InjectLink/idc_ng_hardware/output/bom/idcng.csv

Reference | Qty | Value | DNP | Footprint | Datasheet | Manufacturer_Name | Manufacturer_Part_Number | Mouser Price/Stock | Pricep1 | Pricep10 | Pricep100
C1,C3,C4,C9,C14,C15,C16,C21,C22,C23,C27,C30,C31,C33,C34,C35,C37,C38,C39,C40,C41 | 21 | 100n/16V |  | Capacitor_SMD:C_0201_0603Metric | https://www.yuden.co.jp/productdata/catalog/mlcc02_e.pdf |  |  | https://www.mouser.fr/ProductDetail/TAIYO-YUDEN/EMK063BJ104KP-F | 0,086 | 0,042 | 0,03
C2 | 1 | 47u/10V |  | Capacitor_SMD:C_1210_3225Metric | https://www.mouser.com/catalog/specsheets/TAIYO%20YUDEN_03-05-2025_Tayio_Yuden_1102023_MS_mlcc_all_e-3081579-1-65.pdf |  |  | https://www.mouser.fr/ProductDetail/TAIYO-YUDEN/MSASE32MSB5476MPNA01 | 0,774 | 0,517 | 0,372
C5,C8,C20,C32,C36,C44 | 6 | 10u/16V |  | Capacitor_SMD:C_0805_2012Metric | https://www.samsungsem.com/resources/file/global/support/product_catalog/MLCC.pdf |  |  | https://www.mouser.fr/ProductDetail/Samsung-Electro-Mechanics/CL21A106KOQNNNF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 | 0,086 | 0,03 | 0,026
C6,C7,C17,C25,C26 | 5 | 1u/16V |  | Capacitor_SMD:C_0603_1608Metric | https://www.mouser.fr/datasheet/3/508/1/upy-gphc_x5r_4v-to-50v.pdf |  |  | https://www.mouser.fr/ProductDetail/YAGEO/CC0603KRX5R6BB105 | 0,086 | 0,032 | 0,028
C10 | 1 | 1nF/300VAC |  | VY2102M29Y5US6TV7 | https://www.vishay.com/docs/28535/vy2series.pdf | Vishay | VY2102M29Y5US6TV7 | https://www.mouser.co.uk/ProductDetail/Vishay-BC-Components/VY2102M29Y5US6TV7?qs=L4FwfU3379UNAUtS2WN2jw%3D%3D | 0,189 | 0,098 | 0,009
C19 | 1 | 0.9p/50V |  | Capacitor_SMD:C_0201_0603Metric | https://www.mouser.fr/datasheet/3/76/1/GCQ0335C1HR90WB01-01A.pdf |  |  | https://www.mouser.fr/ProductDetail/Murata-Electronics/GCQ0335C1HR90WB01D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 | 0,155 | 0,09 | 0,055
C24 | 1 | 4.7n/100V |  | Capacitor_SMD:C_0603_1608Metric | https://datasheets.kyocera-avx.com/AutoMLCCKAM.pdf |  |  | https://www.mouser.fr/ProductDetail/KYOCERA-AVX/KAM15AR72A472KT | 0,086 | 0,05 | 0,03
C28 | 1 | 470p/16V |  | Capacitor_SMD:C_0402_1005Metric | https://www.mouser.fr/datasheet/3/508/1/KEM_C1007_X8R_ULTRA_150C_SMD.pdf |  |  | https://www.mouser.fr/ProductDetail/KEMET/C0402C471J4HACAUTO | 0,095 | 0,055 | 0,034
C42 | 1 | 1n/2kV |  | Capacitor_SMD:C_1206_3216Metric | https://www.mouser.fr/datasheet/3/317/1/Middle_and_High_Voltage_DS.pdf |  |  | https://www.mouser.fr/ProductDetail/Walsin/1206B102M202CT?qs=sGAEpiMZZMuMW9TJLBQkXoaTank9xe3KnbzknB7p6j8%3D | 0,108 | 0,039 | 0,033
C43 | 1 | 22u/16V |  | Capacitor_SMD:C_0603_1608Metric | https://www.mouser.fr/datasheet/3/76/1/ZRB18AR61C226ME01-01A.pdf |  |  | https://www.mouser.fr/ProductDetail/Murata-Electronics/ZRB18AR61C226ME01L | 0,378 | 0,247 | 0,152
C45,C46 | 2 | 22p/50V |  | Capacitor_SMD:C_0201_0603Metric | https://www.mouser.fr/datasheet/3/76/1/GCQ0335C1H220JB01-01A.pdf |  |  | https://www.mouser.fr/ProductDetail/Murata-Electronics/GCQ0335C1H220JB01D | 0,103 | 0,041 | 0,024
D1,D7,D8,D9 | 4 | SP3422-04UTG |  | SP342204UTG | https://www.littelfuse.com/media?resourcetype=datasheets&itemid=c0e37064-4c14-4ca3-ae66-fc94f4b4ea0a | LITTELFUSE | SP3422-04UTG | https://www.mouser.co.uk/ProductDetail/Littelfuse/SP3422-04UTG?qs=EU6FO9ffTwfAWj9yOPme2w%3D%3D | 0,09 | 0,09 | 0,09
D2,D3 | 2 | UCLAMP0501H.TCT |  | SODFL1608X70N | https://datasheet.datasheetarchive.com/originals/distributors/Datasheets-30/DSA-588575.pdf | SEMTECH | UCLAMP0501H.TCT | https://www.mouser.fr/ProductDetail/Semtech/UCLAMP0501H.TCT?qs=rBWM4%252BvDhIf5bhuPjughFg%3D%3D | 0,808 | 0,509 | 0,333
D4 | 1 | DESD2CAN2SOQ-7 |  | SOT96P240X110-3N | https://www.mouser.fr/datasheet/3/175/1/DESD2CAN2SOQ.pdf | Diodes Incorporated | DESD2CAN2SOQ-7 | https://www.mouser.fr/ProductDetail/Diodes-Incorporated/DESD2CAN2SOQ-7?qs=jXf%2FRVhl83a30%2FIU4KgEDg%3D%3D | 0,249 | 0,138 | 0,114
D5 | 1 | 150202M153130 |  | 150202M153130 | https://www.we-online.com/components/products/datasheet/150202M153130.pdf |  |  | https://www.mouser.fr/ProductDetail/Wurth-Elektronik/150202M153130?qs=GedFDFLaBXGGSvoPtArHjA%3D%3D | 0,473 | 0,43 | 0,387
D6,D10,D11,D12 | 4 | AQ3130-01ETG |  | AQ313001ETG | https://www.arrow.com/en/products/aq3130-01etg/littelfuse | LITTELFUSE | AQ3130-01ETG | https://www.mouser.co.uk/ProductDetail/Littelfuse/AQ3130-01ETG?qs=AQlKX63v8RuGigjCJJkgEA%3D%3D | 0,103 | 0,096 | 0,096
F1 | 1 | SF-0603F250-2 |  | Fuse:Fuse_0603_1608Metric | https://www.mouser.fr/datasheet/3/40/1/sf0603f.pdf |  |  | https://www.mouser.fr/ProductDetail/Bourns/SF-0603F250-2?qs=GIQXYiEeHGAxmnMqxP70Mw%3D%3D | 0,525 | 0,438 | 0,307
FB2 | 1 | BBGK00160808601Y00 |  | Inductor_SMD:L_0603_1608Metric | https://www.mouser.fr/datasheet/3/203/1/BBGK_Series.pdf |  |  | https://www.mouser.fr/ProductDetail/Pulse-Electronics/BBGK00160808601Y00?qs=DRkmTr78QASbvvb5JKCdog%3D%3D | 0,086 | 0,034 | 0,024
IC1 | 1 | MIE1W0505BGLVH-3R-P |  | MIE1W0505BGLVH3RP | https://www.mouser.de/datasheet/2/277/MIE1W0505BGLVH-3392698.pdf | Monolithic Power Systems (MPS) | MIE1W0505BGLVH-3R-P | https://www.mouser.co.uk/ProductDetail/Monolithic-Power-Systems-MPS/MIE1W0505BGLVH-3R-P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 | 1,57 | 1,54 | 1,46
IC5 | 1 | WFM200S022XNA3 |  | WFM200S022XNA3 | https://www.mouser.fr/datasheet/3/340/1/wfm200_datasheet.pdf | Silicon Labs | WFM200S022XNA3 | https://www.mouser.fr/ProductDetail/Silicon-Labs/WFM200S022XNA3?qs=vEM7xhTegWgk98Fa7%252BnIXQ%3D%3D | 9,6 | 8,34 | 7,31
J1,J7 | 2 | USB4216-03-A |  | USB421603A | https://www.mouser.fr/datasheet/3/1507/1/usb4216.pdf | GCT (GLOBAL CONNECTOR TECHNOLOGY) | USB4216-03-A | https://www.mouser.fr/ProductDetail/GCT/USB4216-03-A?qs=Tc%252BHE9vUsnv1G2UWLFIexA%3D%3D | 0,619 | 0,539 | 0,445
J2 | 1 | 5747845-6 |  | 57478456 | https://www.te.com/commerce/DocumentDelivery/DDEController?Action=srchrtrv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 | TE Connectivity | 5747845-6 | https://www.mouser.fr/ProductDetail/TE-Connectivity/5747845-6?qs=x6EjVpvqMVN9cHT7h3fiVQ%3D%3D | 4,52 | 4,19 | 3,46
J3 | 1 | MEM2052-00-195-00-A |  | MEM20520019500A | https://gct.co/files/drawings/MEM2052.pdf | GCT (GLOBAL CONNECTOR TECHNOLOGY) | MEM2052-00-195-00-A | https://www.mouser.fr/ProductDetail/GCT/MEM2052-00-195-00-A?qs=Jm2GQyTW%2Fbh7Ze6LKWKWwA%3D%3D | 0,955 | 0,777 | 0,634
J4 | 1 | Conn_01x03_Pin |  | Connector_PinHeader_1.00mm:PinHeader_1x03_P1.00mm_Vertical | ~
J6 | 1 | ARJM11C7-009-AB-EW2 |  | ARJM11C7009ABEW2 | https://datasheet.datasheetarchive.com/originals/dk/DKDS41/DSANUWW0031023.pdf | ABRACON | ARJM11C7-009-AB-EW2 | https://www.mouser.co.uk/ProductDetail/ABRACON/ARJM11C7-009-AB-EW2?qs=YCa%2FAAYMW016No73G%2F4GTg%3D%3D | 2,62 | 2,24 | 1,9
L2 | 1 | ACE1V3225-201-R |  | ACE1V3225201R | https://www.eaton.com/content/dam/eaton/products/electronic-components/resources/data-sheet/eaton-ace1v3225-automotive-common-mode-chip-inductor-data-sheet.pdf | Eaton | ACE1V3225-201-R | https://www.mouser.fr/ProductDetail/Eaton-Electronics/ACE1V3225-201-R?qs=YwPsRIUVAOfqgf6EEzwZ8A%3D%3D | 0,593 | 0,513 | 0,413
R1,R3,R4,R8,R39,R40,R42,R43,R44,R48 | 10 | 10k |  | Resistor_SMD:R_0201_0603Metric | https://www.vishay.com/doc?20131 |  |  | https://www.mouser.fr/ProductDetail/Vishay/CRCW020110K0JNEDAT?qs=HMhDvBYWqvNkZNnaYJXRnQ%3D%3D | 0,086 | 0,023 | 0,011
R2,R10,R32,R33 | 4 | 47k |  | Resistor_SMD:R_0201_0603Metric | https://www.vishay.com/doc?20131 |  |  | https://www.mouser.fr/ProductDetail/Vishay/CRCW020147K0FNEDAT | 0,095 | 0,028 | 0,013
R5,R6,R7,R14,R15 | 5 | 5.1k |  | Resistor_SMD:R_0201_0603Metric | https://www.mouser.fr/datasheet/3/508/1/PYu-AF_51_RoHS_L_9.pdf |  |  | https://www.mouser.fr/ProductDetail/YAGEO/AF0201FR-075K1L | 0,086 | 0,018 | 0,015
R9,R13 | 2 | 1M |  | Resistor_SMD:R_1206_3216Metric | https://www.seielect.com/catalog/SEI-RVCU.pdf |  |  | https://www.mouser.fr/ProductDetail/SEI-Stackpole/RVCU1206FT1M00 | 0,163 | 0,084 | 0,048
R11,R12 | 2 | 60 |  | Resistor_SMD:R_0201_0603Metric | https://www.koaspeer.com/pdfs/RK73-RT.pdf |  |  | https://www.mouser.fr/ProductDetail/KOA-Speer/RK73H1HRTTCM60R4F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 | 0,161 | 0,079 | 0,046
R16,R17 | 2 | 470 |  | Inductor_SMD:L_0402_1005Metric | https://industrial.panasonic.com/cdbs/www-data/pdf/RDA0000/AOA0000C304.pdf |  |  | https://www.mouser.fr/ProductDetail/Panasonic/ERJ-2RKF4700X?qs=YMBIwoNQYdXAWydCPK%252BGWQ%3D%3D | 0,095 | 0,016 | 0,009
R18,R36,R37,R38 | 4 | 33 |  | Resistor_SMD:R_0201_0603Metric | https://www.mouser.fr/datasheet/3/40/1/cr.pdf |  |  | https://www.mouser.fr/ProductDetail/Bourns/CR0201-JW-330GLF?qs=W7X4MxMep49DGPs1fsLtAw%3D%3D | 0,086 | 0,012 | 0,006
R29,R30,R31 | 3 | 1k |  | Resistor_SMD:R_0201_0603Metric | https://www.vishay.com/doc?20131 |  |  | https://www.mouser.fr/ProductDetail/Vishay/CRCW02011K00JNEDAT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 | 0,086 | 0,023 | 0,011
R34 | 1 | 12.1k |  | Resistor_SMD:R_0201_0603Metric | https://industrial.panasonic.com/cdbs/www-data/pdf/RDA0000/AOA0000C304.pdf |  |  | https://www.mouser.fr/ProductDetail/Panasonic/ERJ-1GNF1212C?qs=nuXzIS8loXHJzP6GDwqzOQ%3D%3D | 0,086 | 0,022 | 0,012
R41 | 1 | 1.5k |  | Resistor_SMD:R_0402_1005Metric | https://www.mouser.fr/datasheet/3/508/1/PYu-AC_51_RoHS_L_11.pdf |  |  | https://www.mouser.fr/ProductDetail/YAGEO/AC0402FR-7W1K5L | 0,086 | 0,023 | 0,011
R45,R46,R47,R51 | 4 | 49.9 |  | Resistor_SMD:R_0201_0603Metric | https://industrial.panasonic.com/cdbs/www-data/pdf/RDA0000/AOA0000C304.pdf |  |  | https://www.mouser.fr/ProductDetail/Panasonic/ERJ-1GNF49R9C?qs=nuXzIS8loXFTYkbX7W7v9w%3D%3D | 0,086 | 0,022 | 0,012
S1 | 1 | DS04-254-2-03BK-SMT |  | DS04254203BKSMT | https://www.sameskydevices.com/product/resource/ds04-254-smt.pdf | Same Sky | DS04-254-2-03BK-SMT | https://www.mouser.fr/ProductDetail/Same-Sky/DS04-254-2-03BK-SMT?qs=wnTfsH77Xs6HyisDGRVjIg%3D%3D | 0,533 | 0,46 | 0,388
S2,S3 | 2 | FSM4JSMATR |  | FSM4JSMATR | https://www.te.com/commerce/DocumentDelivery/DDEController?Action=srchrtrv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 | TE Connectivity | FSM4JSMATR | https://www.mouser.fr/ProductDetail/TE-Connectivity-Alcoswitch/FSM4JSMATR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 | 0,267 | 0,227 | 0,194
TP1,TP2,TP3,TP4,TP5,TP6,TP7,TP8,TP9 | 9 | TestPoint |  | TestPoint:TestPoint_Pad_D1.0mm | ~
U1 | 1 | 18012015421H |  | Package_SO:SOIC-8_7.5x5.85mm_P1.27mm | https://www.we-online.com/components/products/datasheet/18012015421H.pdf |  |  | https://www.mouser.fr/ProductDetail/Wurth-Elektronik/18012015421H?qs=3GbUB62Nf7d6HxiVQf9dVQ%3D%3D | 1,2 | 1,15 | 1,08
U2 | 1 | CY7C65213-32LTXI |  | Package_DFN_QFN:QFN-32-1EP_5x5mm_P0.5mm_EP3.45x3.45mm | http://www.cypress.com/file/139881/download |  |  |  | 1,86 | 1,57 | 1,5
U5,U10 | 2 | XR33180ESBTR |  | Package_TO_SOT_SMD:TSOT-23-5 | https://www.maxlinear.com/ds/XR33180_XR33181_XR33183_XR33184.pdf |  |  | https://www.mouser.fr/ProductDetail/MaxLinear/XR33180ESBTR?qs=jDo7WO9B8ms2mW%2FHX7Kofg%3D%3D | 0,894 | 0,644 | 0,513
U6 | 1 | KTD2026EWE-TR |  | Package_DFN_QFN:DFN-8-1EP_1.5x1.5mm_P0.4mm_EP0.7x1.2mm | https://www.kinet-ic.com/uploads/KTD2026-7-04h.pdf |  |  | https://www.mouser.fr/datasheet/3/2612/1/KTD2026-7-04h.pdf | 0,49 | 0,344 | 0,268
U7 | 1 | LAN8742A-CZ-TR |  | Package_DFN_QFN:VQFN-24-1EP_4x4mm_P0.5mm_EP2.5x2.5mm_ThermalVias | https://www.mouser.fr/datasheet/3/282/1/DS_LAN8742_00001989A.pdf |  |  | https://www.mouser.fr/ProductDetail/Microchip-Technology/LAN8742A-CZ-TR?qs=6qKXPk0vzx0Y6uPCt7MXWw%3D%3D | 1,32 | 1,32 | 1,01
U8 | 1 | MYC-YF135-4E512D-100-I |  | myir-151:MYCYA151C256N256D65CT |  |  |  |  | 21,24 | 21,24 | 21,24
U9 | 1 | MCP2557FD-H/SN |  | Package_SO:SOIC-8_3.9x4.9mm_P1.27mm | https://ww1.microchip.com/downloads/en/DeviceDoc/20005533A.pdf |  |  | https://www.mouser.fr/ProductDetail/Microchip-Technology/MCP2557FD-H-SN?qs=ZEMkBHnybRFCRky9DdZibQ%3D%3D | 0,912 | 0,912 | 0,688
U11 | 1 | 18012115421H |  | Package_SO:SOIC-8_7.5x5.85mm_P1.27mm | https://www.we-online.com/components/products/datasheet/18012115421H.pdf |  |  | https://www.mouser.fr/ProductDetail/Wurth-Elektronik/18012115421H?qs=3GbUB62Nf7d52g%2F5sk0PkA%3D%3D | 1,2 | 1,15 | 1,08
Y1 | 1 | 8,30106E+11 |  | 8,30106E+11 | https://www.we-online.com/catalog/datasheet/830105863709.pdf | Wurth Elektronik | 8,30106E+11 | https://www.mouser.fr/ProductDetail/Wurth-Elektronik/830105863709?qs=hd1VzrDQEGgXVxZIC%252BUALw%3D%3D | 0,387 | 0,356 | 0,325
