InjectLink/idc_ng_hardware/(list of files, cad)

Other CAD files:
output/3D/idcng.step
