InjectLink/idc_ng_hardware/idcng.kicad_pcb

## KiCad design idcng.kicad_pcb (2026-02-16)

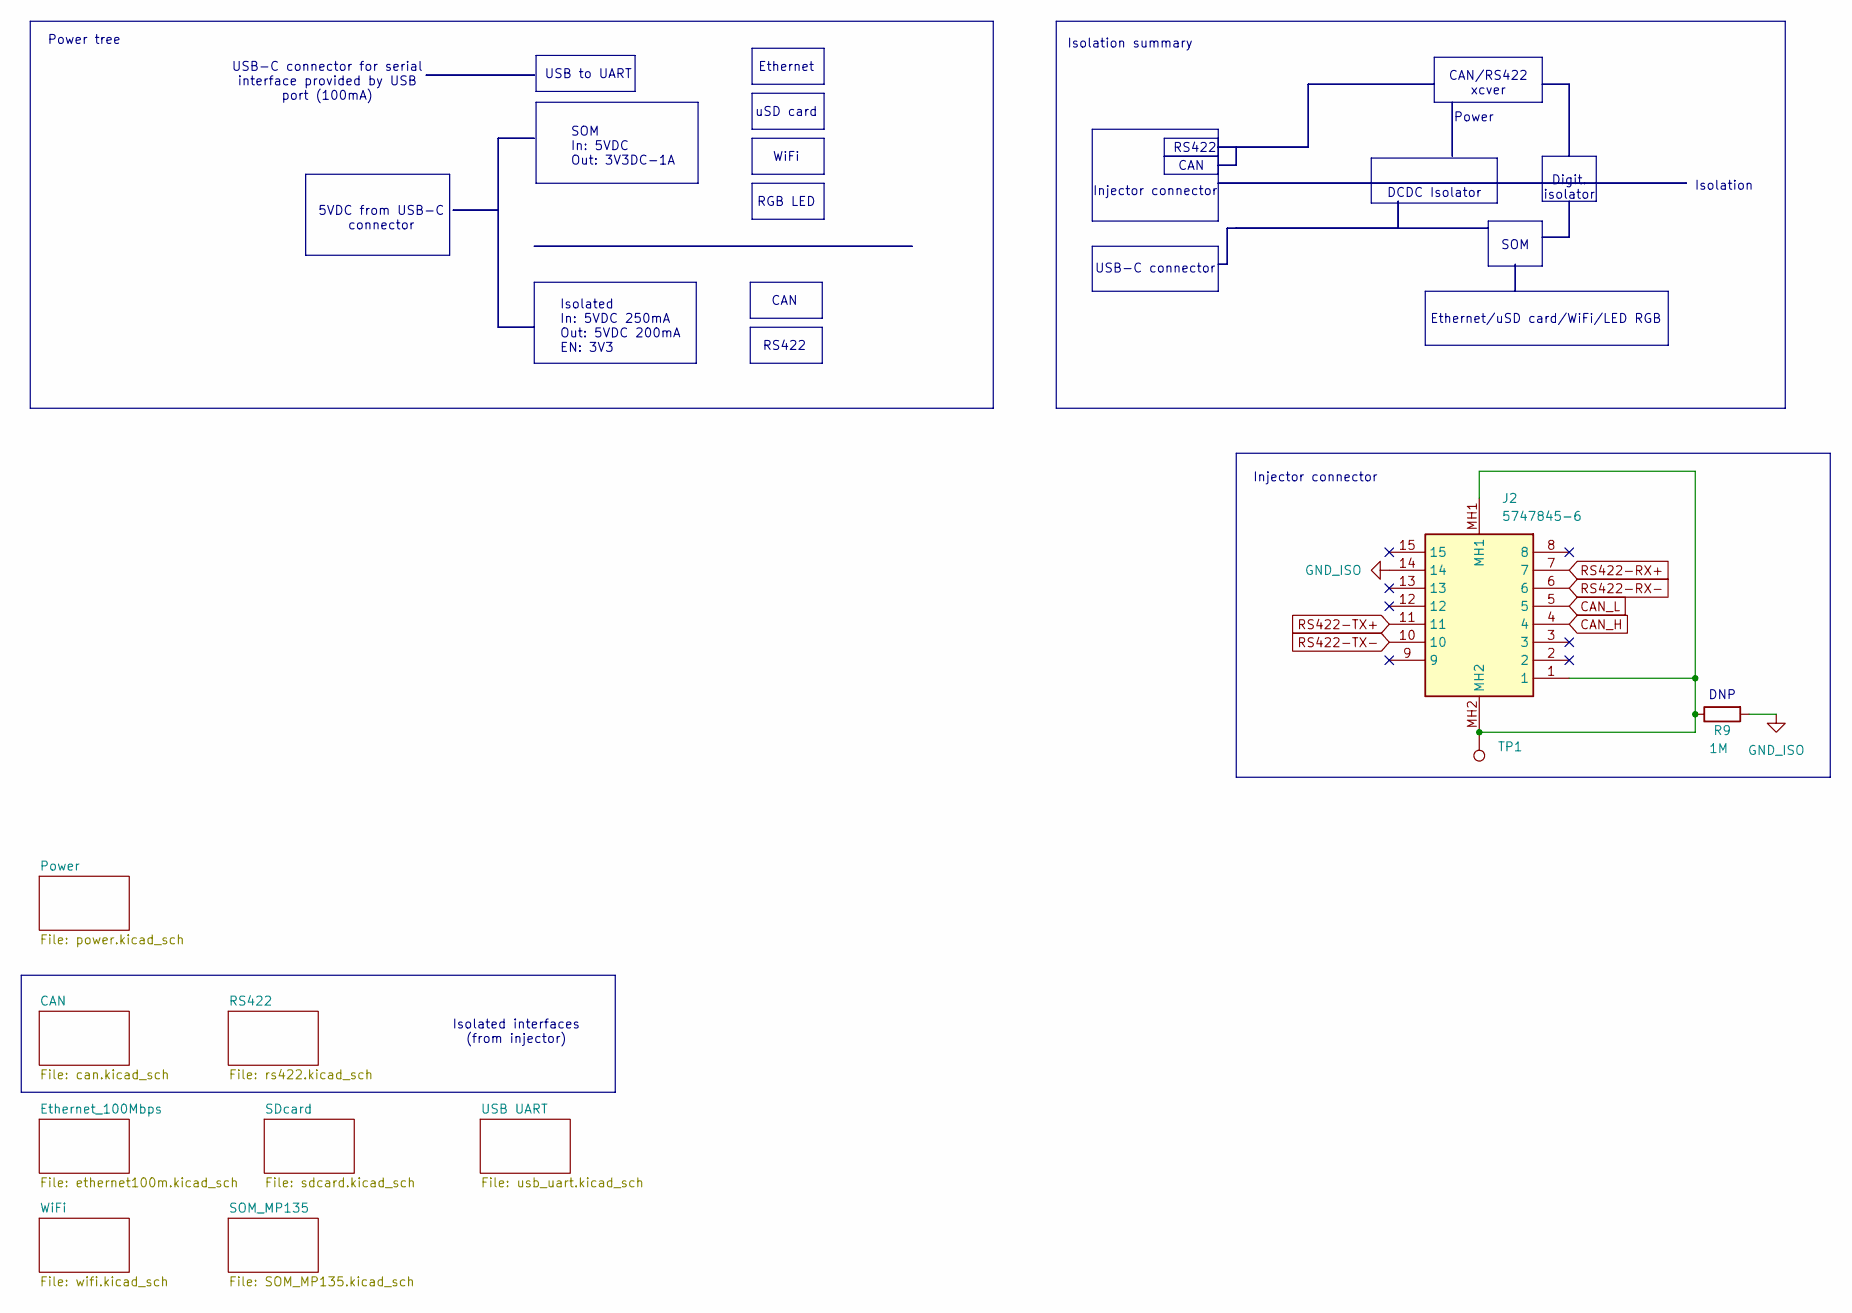
[picture p30: schematic idcng.kicad_sch, IDC-NG]

Parts:
J2: 5747845-6; 57478456; Mouser Part Number 571-5747845-6
R9: 1M; R_1206_3216Metric
TP1: TestPoint; TestPoint_Pad_D1.0mm

Connections:
CAN_H: J2.4; also elsewhere on the board
CAN_L: J2.5; also elsewhere on the board
GND_ISO: J2.14, R9.2; also elsewhere on the board
unnamed: J2.1, J2.MH1, J2.MH2, R9.1, TP1.1
RS422-RX+: J2.7; also elsewhere on the board
RS422-RX-: J2.6; also elsewhere on the board
RS422-TX+: J2.11; also elsewhere on the board
RS422-TX-: J2.10; also elsewhere on the board

Notes on the sheet:
SOM In: 5VDC Out: 3V3DC-1A
WiFi
DCDC Isolator
5VDC from USB-C connector
SOM
Isolated In: 5VDC 250mA Out: 5VDC 200mA EN: 3V3
Injector connector
Ethernet/uSD card/WiFi/LED RGB
Isolated interfaces (from injector)
CAN/RS422 xcver
CAN
Power
RS422
Digit. isolator
uSD card
RGB LED
USB-C connector for serial interface provided by USB port (100mA)
USB to UART
Isolation summary
USB-C connector
Ethernet
Power tree
Isolation
DNP

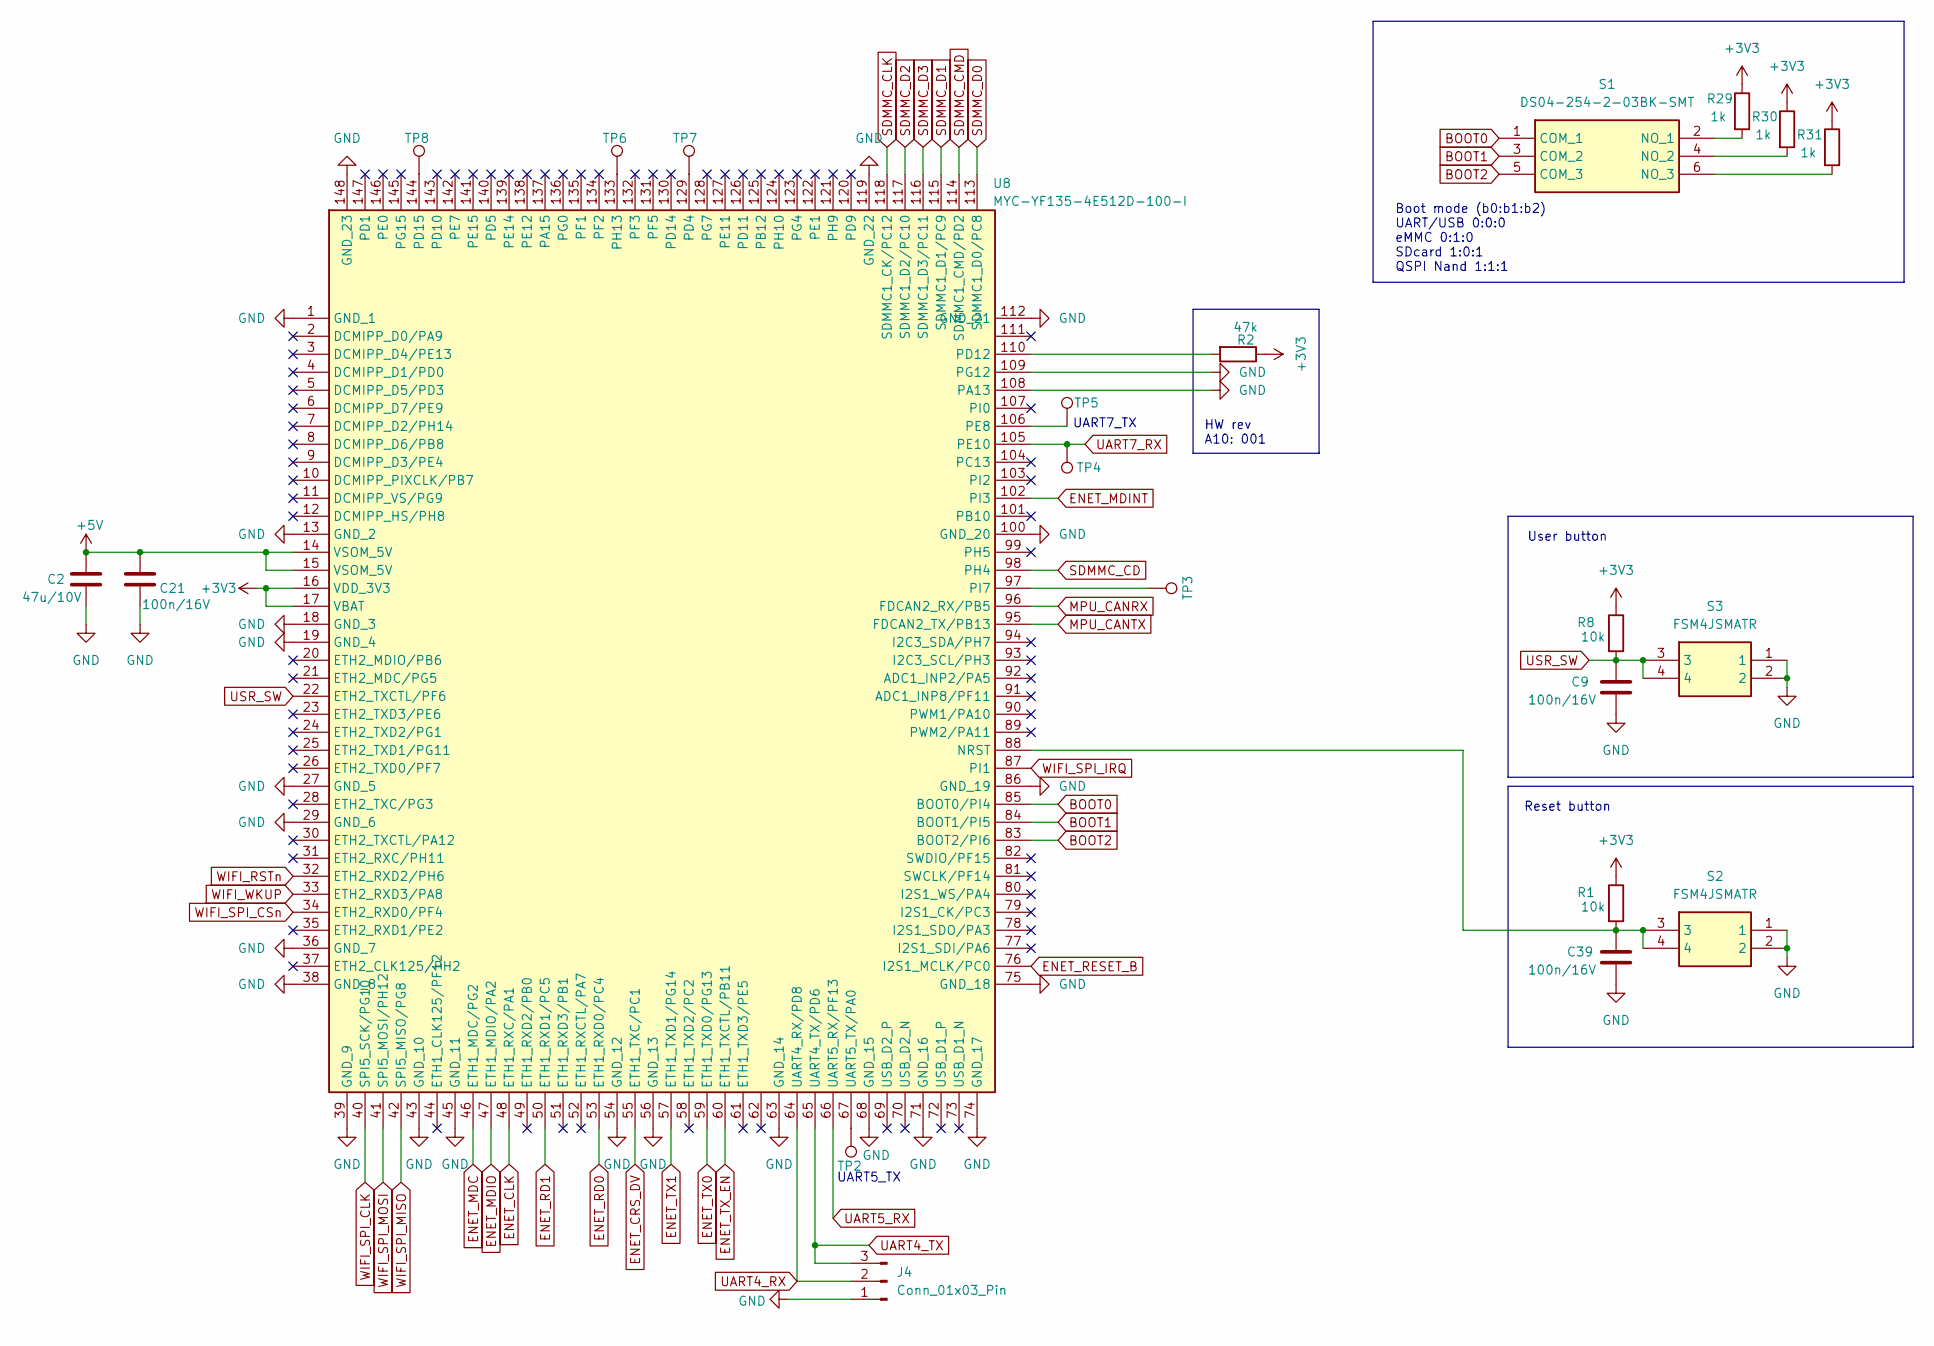
[picture p31: schematic SOM_MP135.kicad_sch, IDC-NG]

Parts:
C2: 47u/10V; C_1210_3225Metric
C9, C21, C39: 100n/16V; C_0201_0603Metric
J4: Conn_01x03_Pin; PinHeader_1x03_P1.00mm_Vertical
R1, R8: 10k; R_0201_0603Metric
R2: 47k; R_0201_0603Metric
R29, R30, R31: 1k; R_0201_0603Metric
S1: DS04-254-2-03BK-SMT; DS04254203BKSMT; Mouser Part Number 490-DS04254203BK-SMT
S2, S3: FSM4JSMATR; Mouser Part Number 506-FSM4JSMATR
TP2, TP3, TP4, TP5, TP6, TP7, TP8: TestPoint; TestPoint_Pad_D1.0mm
U8: MYC-YF135-4E512D-100-I; MYCYA151C256N256D65CT

Connections:
+3V3: R1.1, R2.1, R8.1, R29.1, R30.1, R31.1, U8.16 (VDD_3V3), U8.17 (VBAT); also elsewhere on the board
+5V: C2.1, C21.1, U8.14 (VSOM_5V), U8.15 (VSOM_5V); also elsewhere on the board
BOOT0: S1.1 (COM_1), U8.85 (BOOT0/PI4)
BOOT1: S1.3 (COM_2), U8.84 (BOOT1/PI5)
BOOT2: S1.5 (COM_3), U8.83 (BOOT2/PI6)
ENET_CLK: U8.48 (ETH1_RXC/PA1); also elsewhere on the board
ENET_CRS_DV: U8.55 (ETH1_TXC/PC1); also elsewhere on the board
ENET_MDC: U8.46 (ETH1_MDC/PG2); also elsewhere on the board
ENET_MDINT: U8.102 (PI3); also elsewhere on the board
ENET_MDIO: U8.47 (ETH1_MDIO/PA2); also elsewhere on the board
ENET_RD0: U8.53 (ETH1_RXD0/PC4); also elsewhere on the board
ENET_RD1: U8.50 (ETH1_RXD1/PC5); also elsewhere on the board
ENET_RESET_B: U8.76 (I2S1_MCLK/PC0); also elsewhere on the board
ENET_TX0: U8.59 (ETH1_TXD0/PG13); also elsewhere on the board
ENET_TX1: U8.57 (ETH1_TXD1/PG14); also elsewhere on the board
ENET_TX_EN: U8.60 (ETH1_TXCTL/PB11); also elsewhere on the board
GND: C2.2, C9.2, C21.2, C39.2, J4.1, S2.1, S2.2, S3.1, S3.2, U8.1 (GND_1), U8.13 (GND_2), U8.18 (GND_3), U8.19 (GND_4), U8.27 (GND_5), U8.29 (GND_6), U8.36 (GND_7), U8.38 (GND_8), U8.39 (GND_9), U8.43 (GND_10), U8.45 (GND_11), U8.54 (GND_12), U8.56 (GND_13), U8.63 (GND_14), U8.68 (GND_15), U8.71 (GND_16), U8.74 (GND_17), U8.75 (GND_18), U8.86 (GND_19), U8.100 (GND_20), U8.108 (PA13), U8.109 (PG12), U8.112 (GND_21), U8.119 (GND_22), U8.148 (GND_23); also elsewhere on the board
MPU_CANRX: U8.96 (FDCAN2_RX/PB5); also elsewhere on the board
MPU_CANTX: U8.95 (FDCAN2_TX/PB13); also elsewhere on the board
unnamed: R29.2, S1.2 (NO_1)
unnamed: R30.2, S1.4 (NO_2)
unnamed: R31.2, S1.6 (NO_3)
unnamed: C39.1, R1.2, S2.3, S2.4, U8.88 (NRST)
unnamed: TP7.1, U8.129 (PD4)
unnamed: R2.2, U8.110 (PD12)
unnamed: TP8.1, U8.144 (PD15)
unnamed: TP5.1, U8.106 (PE8)
unnamed: TP6.1, U8.133 (PH13)
unnamed: TP3.1, U8.97 (PI7)
unnamed: TP2.1, U8.67 (UART5_TX/PA0)
SDMMC_CD: U8.98 (PH4); also elsewhere on the board
SDMMC_CLK: U8.118 (SDMMC1_CK/PC12); also elsewhere on the board
SDMMC_CMD: U8.114 (SDMMC1_CMD/PD2); also elsewhere on the board
SDMMC_D0: U8.113 (SDMMC1_D0/PC8); also elsewhere on the board
SDMMC_D1: U8.115 (SDMMC1_D1/PC9); also elsewhere on the board
SDMMC_D2: U8.117 (SDMMC1_D2/PC10); also elsewhere on the board
SDMMC_D3: U8.116 (SDMMC1_D3/PC11); also elsewhere on the board
UART4_RX: J4.2, U8.64 (UART4_RX/PD8); also elsewhere on the board
UART4_TX: J4.3, U8.65 (UART4_TX/PD6); also elsewhere on the board
UART5_RX: U8.66 (UART5_RX/PF13); also elsewhere on the board
UART7_RX: TP4.1, U8.105 (PE10); also elsewhere on the board
USR_SW: C9.1, R8.2, S3.3, S3.4, U8.22 (ETH2_TXCTL/PF6)
WIFI_RSTn: U8.32 (ETH2_RXD2/PH6); also elsewhere on the board
WIFI_SPI_CLK: U8.40 (SPI5_SCK/PG10); also elsewhere on the board
WIFI_SPI_CSn: U8.34 (ETH2_RXD0/PF4); also elsewhere on the board
WIFI_SPI_IRQ: U8.87 (PI1); also elsewhere on the board
WIFI_SPI_MISO: U8.42 (SPI5_MISO/PG8); also elsewhere on the board
WIFI_SPI_MOSI: U8.41 (SPI5_MOSI/PH12); also elsewhere on the board
WIFI_WKUP: U8.33 (ETH2_RXD3/PA8); also elsewhere on the board

Notes on the sheet:
HW rev A10: 001
UART5_TX
Reset button
Boot mode (b0:b1:b2) UART/USB 0:0:0 eMMC 0:1:0 SDcard 1:0:1 QSPI Nand 1:1:1
UART7_TX
User button

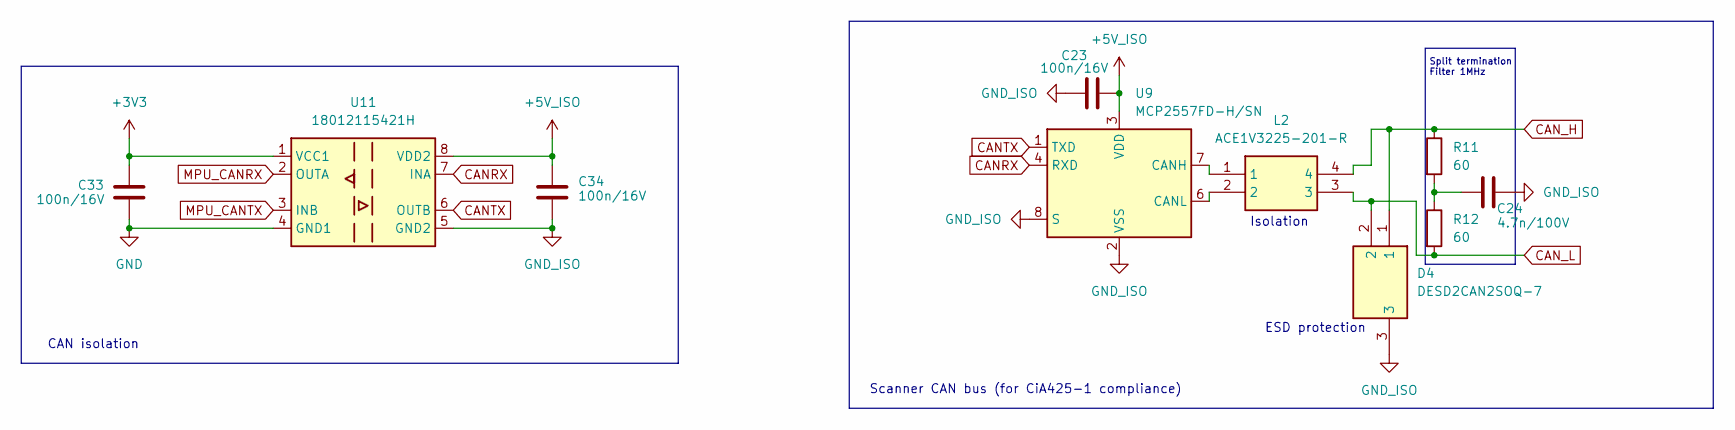
[picture p32: schematic can.kicad_sch, IDC-NG]

Parts:
C23, C33, C34: 100n/16V; C_0201_0603Metric
C24: 4.7n/100V; C_0603_1608Metric
D4: DESD2CAN2SOQ-7; SOT96P240X110-3N; Mouser Part Number 621-DESD2CAN2SOQ-7
L2: ACE1V3225-201-R; ACE1V3225201R; Mouser Part Number 504-ACE1V3225-201-R
R11, R12: 60; R_0201_0603Metric
U9: MCP2557FD-H/SN; SOIC-8_3.9x4.9mm_P1.27mm
U11: 18012115421H; SOIC-8_7.5x5.85mm_P1.27mm

Connections:
+3V3: C33.1, U11.1 (VCC1); also elsewhere on the board
+5V_ISO: C23.2, C34.1, U9.3 (VDD), U11.8 (VDD2); also elsewhere on the board
CANRX: U9.4 (RXD), U11.7 (INA)
CANTX: U9.1 (TXD), U11.6 (OUTB)
CAN_H: D4.1, L2.4, R11.1; also elsewhere on the board
CAN_L: D4.2, L2.3, R12.2; also elsewhere on the board
GND: C33.2, U11.4 (GND1); also elsewhere on the board
GND_ISO: C23.1, C24.1, C34.2, D4.3, U9.2 (VSS), U9.8 (S), U11.5 (GND2); also elsewhere on the board
MPU_CANRX: U11.2 (OUTA); also elsewhere on the board
MPU_CANTX: U11.3 (INB); also elsewhere on the board
unnamed: C24.2, R11.2, R12.1
unnamed: L2.1, U9.7 (CANH)
unnamed: L2.2, U9.6 (CANL)

Notes on the sheet:
ESD protection
Scanner CAN bus (for CiA425-1 compliance)
Split termination Filter 1MHz
Isolation
CAN isolation

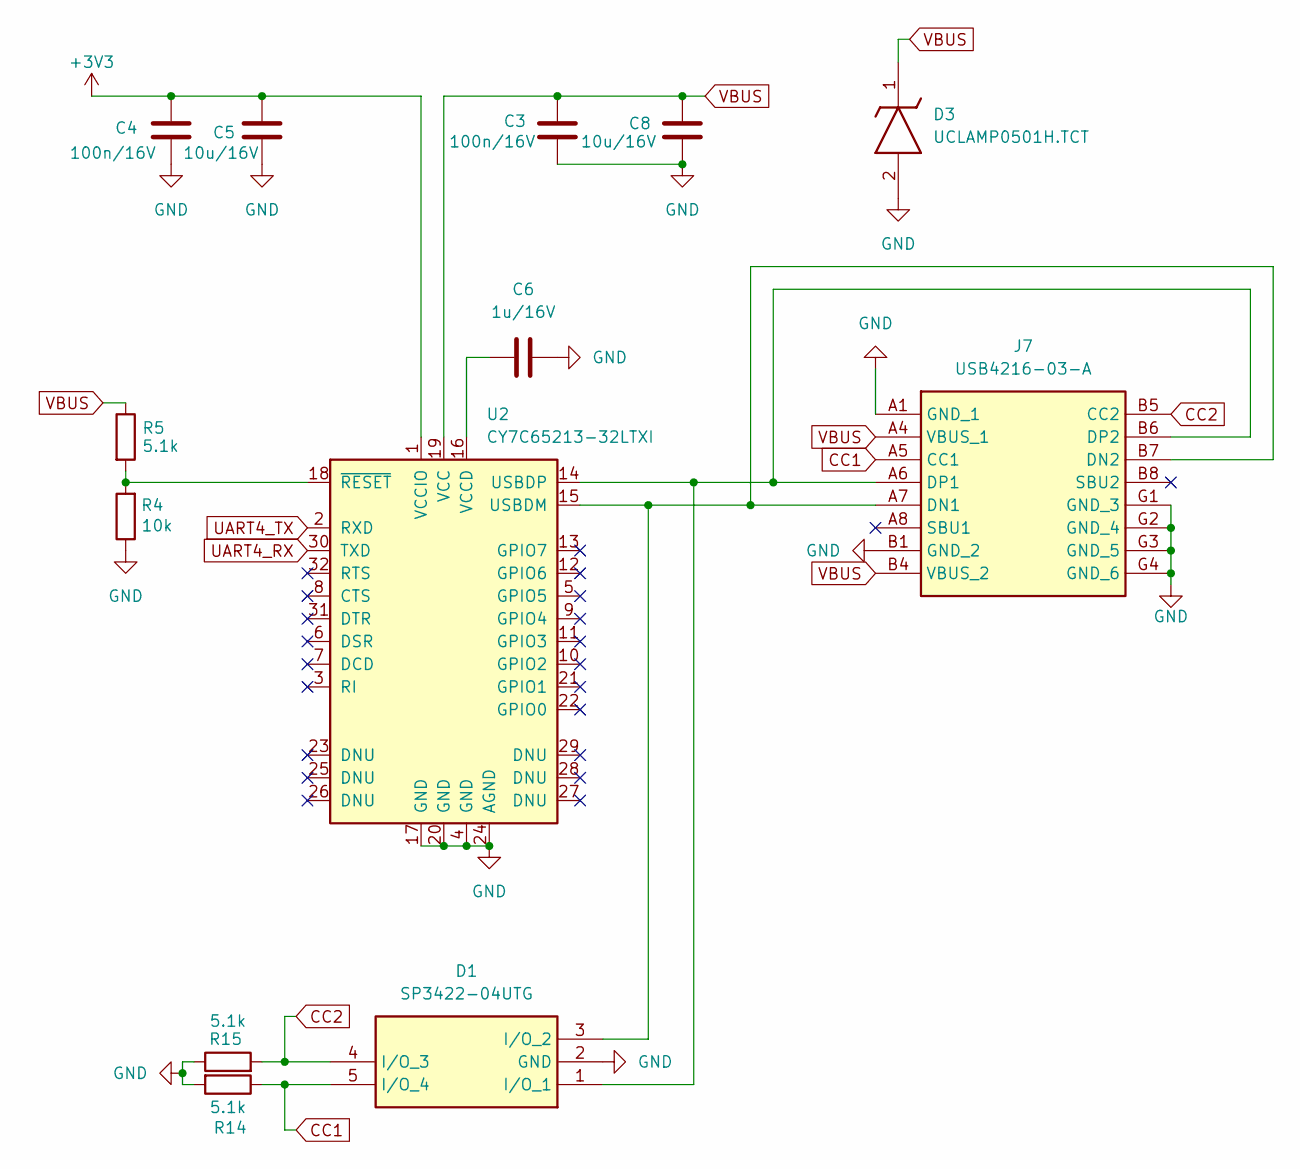
[picture p33: schematic usb_uart.kicad_sch, IDC-NG]

Parts:
C3, C4: 100n/16V; C_0201_0603Metric
C5, C8: 10u/16V; C_0805_2012Metric
C6: 1u/16V; C_0603_1608Metric
D1: SP3422-04UTG; SP342204UTG; Mouser Part Number 576-SP3422-04UTG
D3: UCLAMP0501H.TCT; SODFL1608X70N; Mouser Part Number 947-UCLAMP0501H.TCT
J7: USB4216-03-A; USB421603A; Mouser Part Number 640-USB4216-03-A
R4: 10k; R_0201_0603Metric
R5, R14, R15: 5.1k; R_0201_0603Metric
U2: CY7C65213-32LTXI; QFN-32-1EP_5x5mm_P0.5mm_EP3.45x3.45mm

Connections:
+3V3: C4.1, C5.1, U2.1 (VCCIO); also elsewhere on the board
CC1: D1.5 (I/O_4), J7.A5 (CC1), R14.1
CC2: D1.4 (I/O_3), J7.B5 (CC2), R15.2
GND: C3.2, C4.2, C5.2, C6.1, C8.2, D1.2 (GND), D3.2 (A), J7.A1 (GND_1), J7.B1 (GND_2), J7.G1 (GND_3), J7.G2 (GND_4), J7.G3 (GND_5), J7.G4 (GND_6), R4.1, R14.2, R15.1, U2.4 (GND), U2.17 (GND), U2.20 (GND), U2.24 (AGND); also elsewhere on the board
unnamed: D1.1 (I/O_1), J7.A6 (DP1), J7.B6 (DP2), U2.14 (USBDP)
unnamed: D1.3 (I/O_2), J7.A7 (DN1), J7.B7 (DN2), U2.15 (USBDM)
unnamed: C6.2, U2.16 (VCCD)
unnamed: R4.2, R5.2, U2.18 (~RESET)
UART4_RX: U2.30 (TXD); also elsewhere on the board
UART4_TX: U2.2 (RXD); also elsewhere on the board
VBUS: C3.1, C8.1, D3.1 (K), J7.A4 (VBUS_1), J7.B4 (VBUS_2), R5.1, U2.19 (VCC)

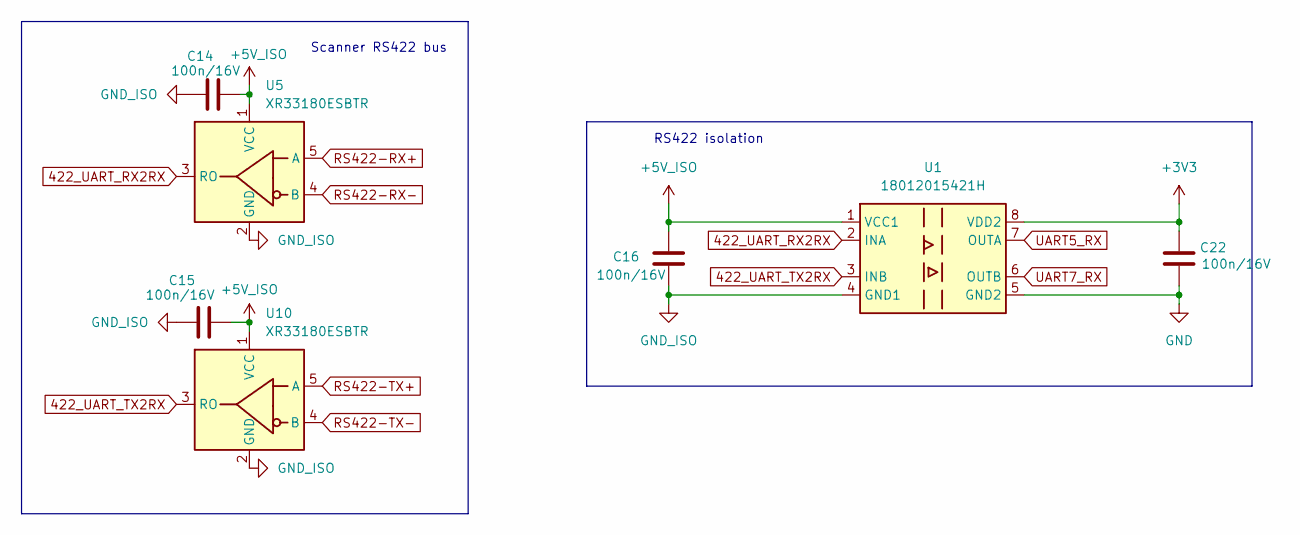
[picture p34: schematic rs422.kicad_sch, IDC-NG]

Parts:
C14, C15, C16, C22: 100n/16V; C_0201_0603Metric
U1: 18012015421H; SOIC-8_7.5x5.85mm_P1.27mm
U5, U10: XR33180ESBTR; TSOT-23-5

Connections:
422_UART_RX2RX: U1.2 (INA), U5.3 (RO)
422_UART_TX2RX: U1.3 (INB), U10.3 (RO)
+3V3: C22.1, U1.8 (VDD2); also elsewhere on the board
+5V_ISO: C14.1, C15.1, C16.1, U1.1 (VCC1), U5.1 (VCC), U10.1 (VCC); also elsewhere on the board
GND: C22.2, U1.5 (GND2); also elsewhere on the board
GND_ISO: C14.2, C15.2, C16.2, U1.4 (GND1), U5.2 (GND), U10.2 (GND); also elsewhere on the board
RS422-RX+: U5.5 (A); also elsewhere on the board
RS422-RX-: U5.4 (B); also elsewhere on the board
RS422-TX+: U10.5 (A); also elsewhere on the board
RS422-TX-: U10.4 (B); also elsewhere on the board
UART5_RX: U1.7 (OUTA); also elsewhere on the board
UART7_RX: U1.6 (OUTB); also elsewhere on the board

Notes on the sheet:
RS422 isolation
Scanner RS422 bus

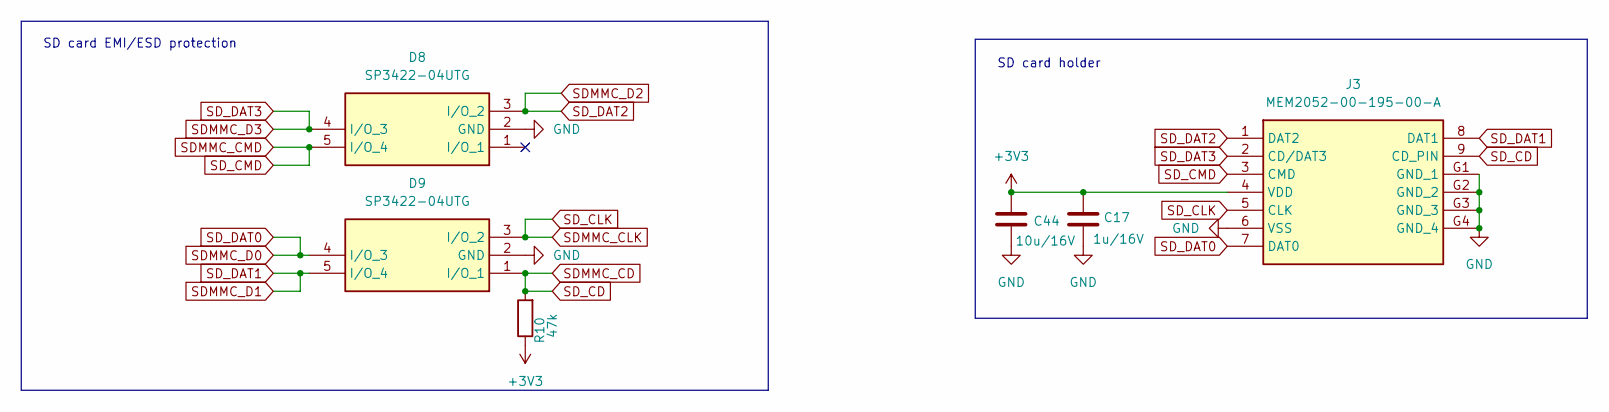
[picture p35: schematic sdcard.kicad_sch, IDC-NG]

Parts:
C17: 1u/16V; C_0603_1608Metric
C44: 10u/16V; C_0805_2012Metric
D8, D9: SP3422-04UTG; SP342204UTG; Mouser Part Number 576-SP3422-04UTG
J3: MEM2052-00-195-00-A; MEM20520019500A; Mouser Part Number 640-MEM20520019500A
R10: 47k; R_0201_0603Metric

Connections:
+3V3: C17.1, C44.1, J3.4 (VDD), R10.1; also elsewhere on the board
GND: C17.2, C44.2, D8.2 (GND), D9.2 (GND), J3.6 (VSS), J3.G1 (GND_1), J3.G2 (GND_2), J3.G3 (GND_3), J3.G4 (GND_4); also elsewhere on the board
SDMMC_CD: D9.1 (I/O_1), J3.9 (CD_PIN), R10.2; also elsewhere on the board
SDMMC_CLK: D9.3 (I/O_2), J3.5 (CLK); also elsewhere on the board
SDMMC_CMD: D8.5 (I/O_4), J3.3 (CMD); also elsewhere on the board
SDMMC_D0: D9.4 (I/O_3), J3.7 (DAT0); also elsewhere on the board
SDMMC_D1: D9.5 (I/O_4), J3.8 (DAT1); also elsewhere on the board
SDMMC_D2: D8.3 (I/O_2), J3.1 (DAT2); also elsewhere on the board
SDMMC_D3: D8.4 (I/O_3), J3.2 (CD/DAT3); also elsewhere on the board

Notes on the sheet:
SD card EMI/ESD protection
SD card holder

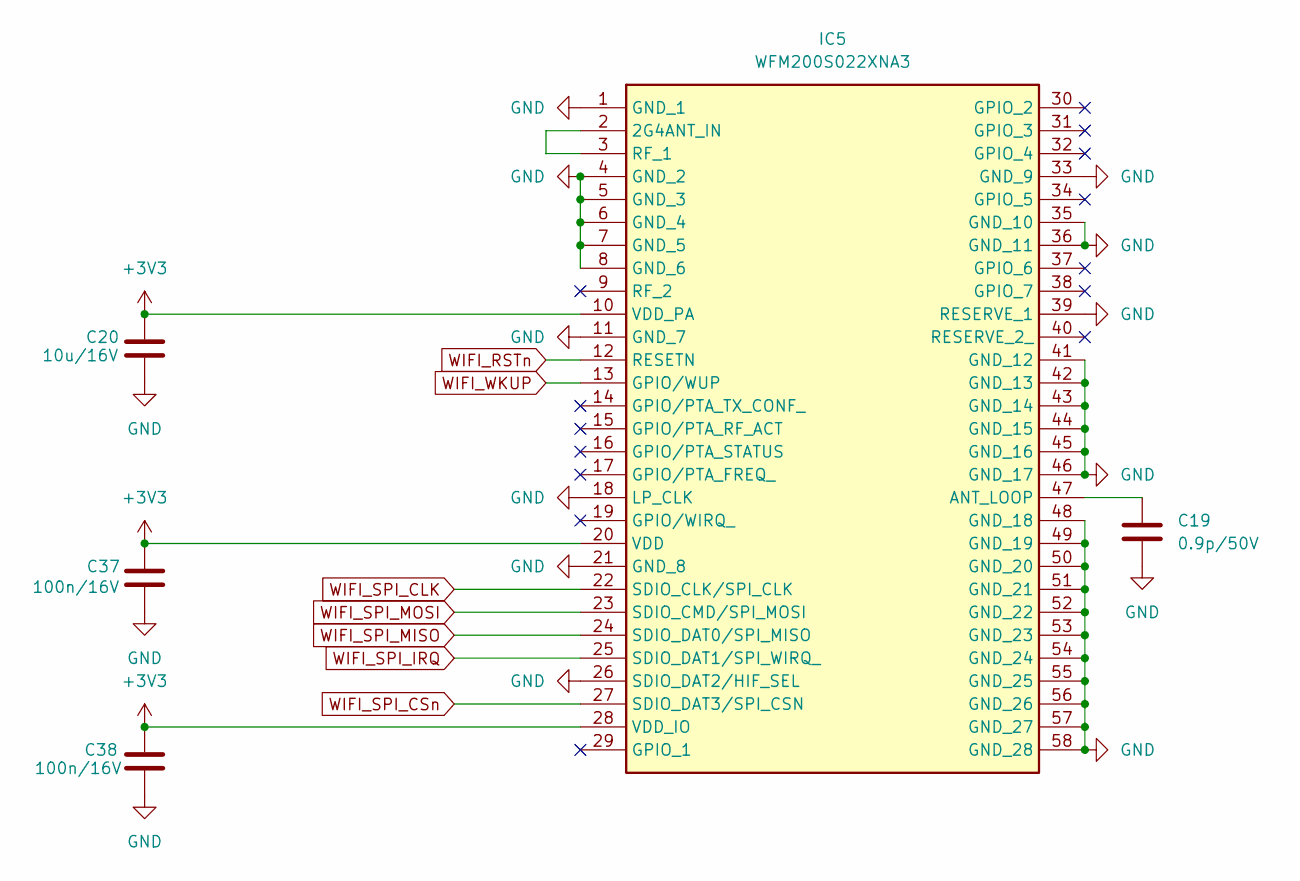
[picture p36: schematic wifi.kicad_sch, IDC-NG]

Parts:
C19: 0.9p/50V; C_0201_0603Metric
C20: 10u/16V; C_0805_2012Metric
C37, C38: 100n/16V; C_0201_0603Metric
IC5: WFM200S022XNA3; Mouser Part Number 634-WFM200S022XNA3

Connections:
+3V3: C20.1, C37.1, C38.1, IC5.10 (VDD_PA), IC5.20 (VDD), IC5.28 (VDD_IO); also elsewhere on the board
GND: C19.2, C20.2, C37.2, C38.2, IC5.1 (GND_1), IC5.4 (GND_2), IC5.5 (GND_3), IC5.6 (GND_4), IC5.7 (GND_5), IC5.8 (GND_6), IC5.11 (GND_7), IC5.18 (LP_CLK), IC5.21 (GND_8), IC5.26 (SDIO_DAT2/HIF_SEL), IC5.33 (GND_9), IC5.35 (GND_10), IC5.36 (GND_11), IC5.39 (RESERVE_1), IC5.41 (GND_12), IC5.42 (GND_13), IC5.43 (GND_14), IC5.44 (GND_15), IC5.45 (GND_16), IC5.46 (GND_17), IC5.48 (GND_18), IC5.49 (GND_19), IC5.50 (GND_20), IC5.51 (GND_21), IC5.52 (GND_22), IC5.53 (GND_23), IC5.54 (GND_24), IC5.55 (GND_25), IC5.56 (GND_26), IC5.57 (GND_27), IC5.58 (GND_28); also elsewhere on the board
unnamed: IC5.2 (2G4ANT_IN), IC5.3 (RF_1)
unnamed: C19.1, IC5.47 (ANT_LOOP)
WIFI_RSTn: IC5.12 (RESETN); also elsewhere on the board
WIFI_SPI_CLK: IC5.22 (SDIO_CLK/SPI_CLK); also elsewhere on the board
WIFI_SPI_CSn: IC5.27 (SDIO_DAT3/SPI_CSN); also elsewhere on the board
WIFI_SPI_IRQ: IC5.25 (SDIO_DAT1/SPI_WIRQ_); also elsewhere on the board
WIFI_SPI_MISO: IC5.24 (SDIO_DAT0/SPI_MISO); also elsewhere on the board
WIFI_SPI_MOSI: IC5.23 (SDIO_CMD/SPI_MOSI); also elsewhere on the board
WIFI_WKUP: IC5.13 (GPIO/WUP); also elsewhere on the board

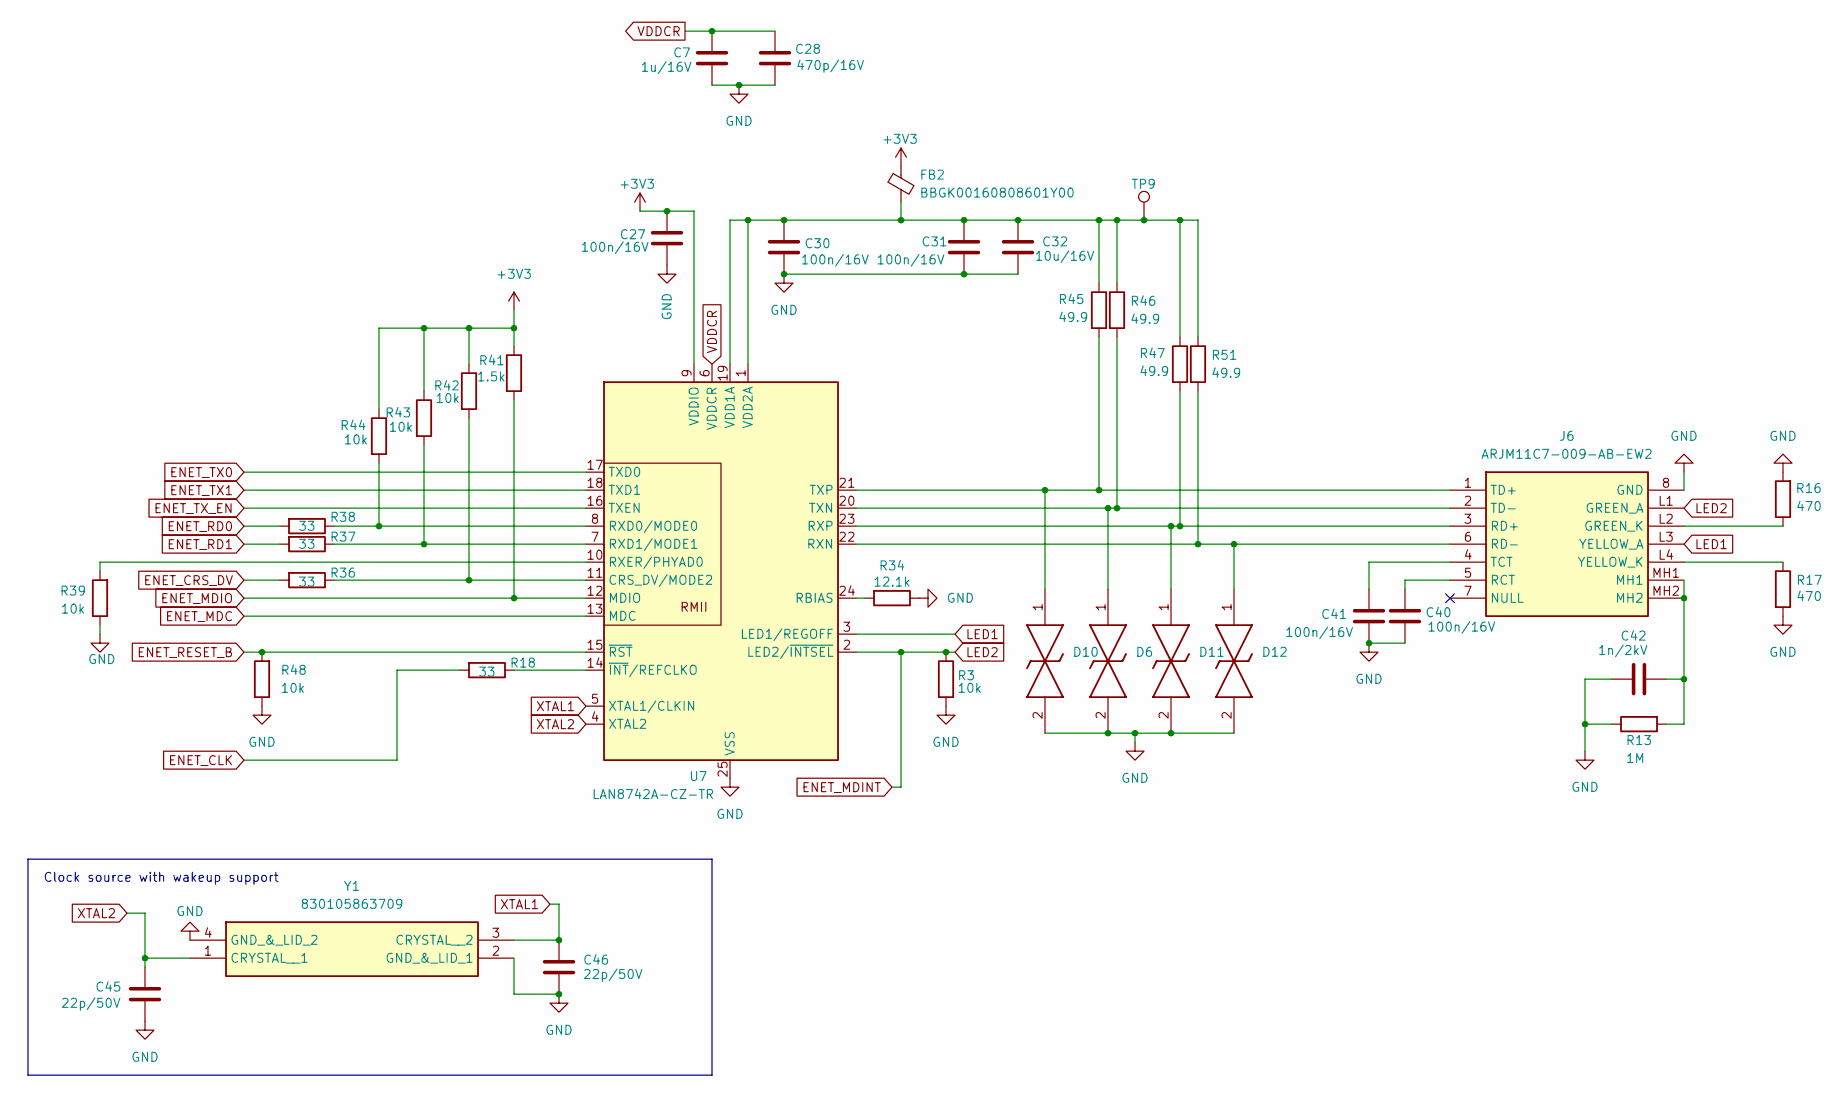
[picture p37: schematic ethernet100m.kicad_sch, IDC-NG]

Parts:
C7: 1u/16V; C_0603_1608Metric
C27, C30, C31, C40, C41: 100n/16V; C_0201_0603Metric
C28: 470p/16V; C_0402_1005Metric
C32: 10u/16V; C_0805_2012Metric
C42: 1n/2kV; C_1206_3216Metric
C45, C46: 22p/50V; C_0201_0603Metric
D6, D10, D11, D12: AQ3130-01ETG; AQ313001ETG; Mouser Part Number 576-AQ3130-01ETG
FB2: BBGK00160808601Y00; L_0603_1608Metric
J6: ARJM11C7-009-AB-EW2; ARJM11C7009ABEW2; Mouser Part Number 815-RJM11C7009ABEW2
R3, R39, R42, R43, R44, R48: 10k; R_0201_0603Metric
R13: 1M; R_1206_3216Metric
R16, R17: 470; L_0402_1005Metric
R18, R36, R37, R38: 33; R_0201_0603Metric
R34: 12.1k; R_0201_0603Metric
R41: 1.5k; R_0402_1005Metric; Part AC0402FR-7W1K5L
R45, R46, R47, R51: 49.9; R_0201_0603Metric
TP9: TestPoint; TestPoint_Pad_D1.0mm
U7: LAN8742A-CZ-TR; VQFN-24-1EP_4x4mm_P0.5mm_EP2.5x2.5mm_ThermalVias
Y1: 830105863709; Mouser Part Number 710-830105863709

Connections:
+3V3: C27.1, FB2.1, R41.1, R42.1, R43.1, R44.1, U7.9 (VDDIO); also elsewhere on the board
ENET_CLK: R18.2; also elsewhere on the board
ENET_CRS_DV: R36.2; also elsewhere on the board
ENET_MDC: U7.13 (MDC); also elsewhere on the board
ENET_MDINT: J6.L1 (GREEN_A), R3.1, U7.2 (LED2/~INTSEL); also elsewhere on the board
ENET_MDIO: R41.2, U7.12 (MDIO); also elsewhere on the board
ENET_RD0: R38.2; also elsewhere on the board
ENET_RD1: R37.2; also elsewhere on the board
ENET_RESET_B: R48.2, U7.15 (~RST); also elsewhere on the board
ENET_TX0: U7.17 (TXD0); also elsewhere on the board
ENET_TX1: U7.18 (TXD1); also elsewhere on the board
ENET_TX_EN: U7.16 (TXEN); also elsewhere on the board
GND: C7.2, C27.2, C28.2, C30.1, C31.1, C32.1, C40.1, C41.1, C42.1, C45.2, C46.2, D6.2, D10.2, D11.2, D12.2, J6.8 (GND), R3.2, R13.1, R16.2, R17.2, R34.1, R39.1, R48.1, U7.25 (VSS), Y1.2 (GND_&_LID_1), Y1.4 (GND_&_LID_2); also elsewhere on the board
LED1: J6.L3 (YELLOW_A), U7.3 (LED1/REGOFF)
unnamed: C42.2, J6.MH1, J6.MH2, R13.2
unnamed: J6.L2 (GREEN_K), R16.1
unnamed: C40.2, J6.5 (RCT)
unnamed: D11.1, J6.3 (RD+), R47.2, U7.23 (RXP)
unnamed: D12.1, J6.6 (RD-), R51.2, U7.22 (RXN)
unnamed: C41.2, J6.4 (TCT)
unnamed: D10.1, J6.1 (TD+), R45.2, U7.21 (TXP)
unnamed: D6.1, J6.2 (TD-), R46.2, U7.20 (TXN)
unnamed: J6.L4 (YELLOW_K), R17.1
unnamed: R36.1, R42.2, U7.11 (CRS_DV/MODE2)
unnamed: R34.2, U7.24 (RBIAS)
unnamed: R38.1, R44.2, U7.8 (RXD0/MODE0)
unnamed: R37.1, R43.2, U7.7 (RXD1/MODE1)
unnamed: R39.2, U7.10 (RXER/PHYAD0)
unnamed: C30.2, C31.2, C32.2, FB2.2, R45.1, R46.1, R47.1, R51.1, TP9.1, U7.1 (VDD2A), U7.19 (VDD1A)
unnamed 59: R18.1, U7.14 (~INT/REFCLKO); also elsewhere on the board
VDDCR: C7.1, C28.1, U7.6 (VDDCR)
XTAL1: C46.1, U7.5 (XTAL1/CLKIN), Y1.3 (CRYSTAL__2)
XTAL2: C45.1, U7.4 (XTAL2), Y1.1 (CRYSTAL__1)

Notes on the sheet:
Clock source with wakeup support

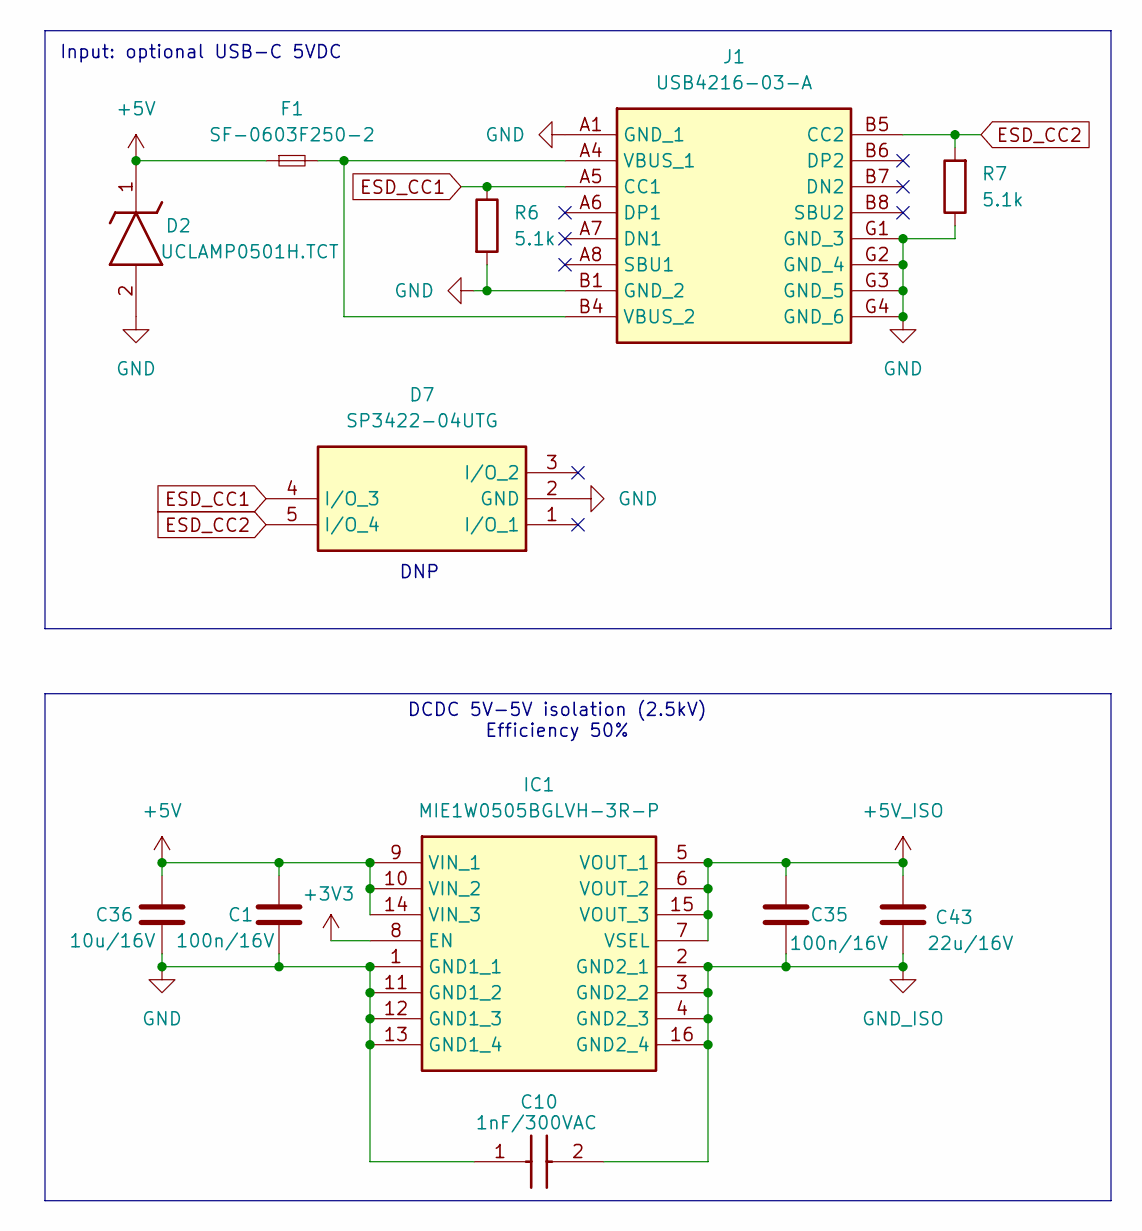
[picture p38: schematic power.kicad_sch, IDC-NG]

Parts:
C1, C35: 100n/16V; C_0201_0603Metric
C10: 1nF/300VAC; VY2102M29Y5US6TV7; Mouser Part Number 72-VY2102M29Y5US6TV7
C36: 10u/16V; C_0805_2012Metric
C43: 22u/16V; C_0603_1608Metric
D2: UCLAMP0501H.TCT; SODFL1608X70N; Mouser Part Number 947-UCLAMP0501H.TCT
D7: SP3422-04UTG; SP342204UTG; Mouser Part Number 576-SP3422-04UTG
F1: SF-0603F250-2; Fuse_0603_1608Metric
IC1: MIE1W0505BGLVH-3R-P; MIE1W0505BGLVH3RP; Mouser Part Number 946-MIE1W0505BGLVH3P
J1: USB4216-03-A; USB421603A; Mouser Part Number 640-USB4216-03-A
R6, R7: 5.1k; R_0201_0603Metric

Connections:
+3V3: IC1.8 (EN); also elsewhere on the board
+5V: C1.1, C36.1, D2.1 (K), F1.1, IC1.9 (VIN_1), IC1.10 (VIN_2), IC1.14 (VIN_3); also elsewhere on the board
+5V_ISO: C35.1, C43.1, IC1.5 (VOUT_1), IC1.6 (VOUT_2), IC1.7 (VSEL), IC1.15 (VOUT_3); also elsewhere on the board
ESD_CC1: D7.4 (I/O_3), J1.A5 (CC1), R6.1
ESD_CC2: D7.5 (I/O_4), J1.B5 (CC2), R7.2
GND: C1.2, C10.1, C36.2, D2.2 (A), D7.2 (GND), IC1.1 (GND1_1), IC1.11 (GND1_2), IC1.12 (GND1_3), IC1.13 (GND1_4), J1.A1 (GND_1), J1.B1 (GND_2), J1.G1 (GND_3), J1.G2 (GND_4), J1.G3 (GND_5), J1.G4 (GND_6), R6.2, R7.1; also elsewhere on the board
GND_ISO: C10.2, C35.2, C43.2, IC1.2 (GND2_1), IC1.3 (GND2_2), IC1.4 (GND2_3), IC1.16 (GND2_4); also elsewhere on the board
unnamed: F1.2, J1.A4 (VBUS_1), J1.B4 (VBUS_2)

Notes on the sheet:
DNP
DCDC 5V-5V isolation (2.5kV) Efficiency 50%
Input: optional USB-C 5VDC
