InjectLink/idc_ng_hardware/idcng.kicad_pcb

## KiCad design idcng.kicad_pcb (continued)

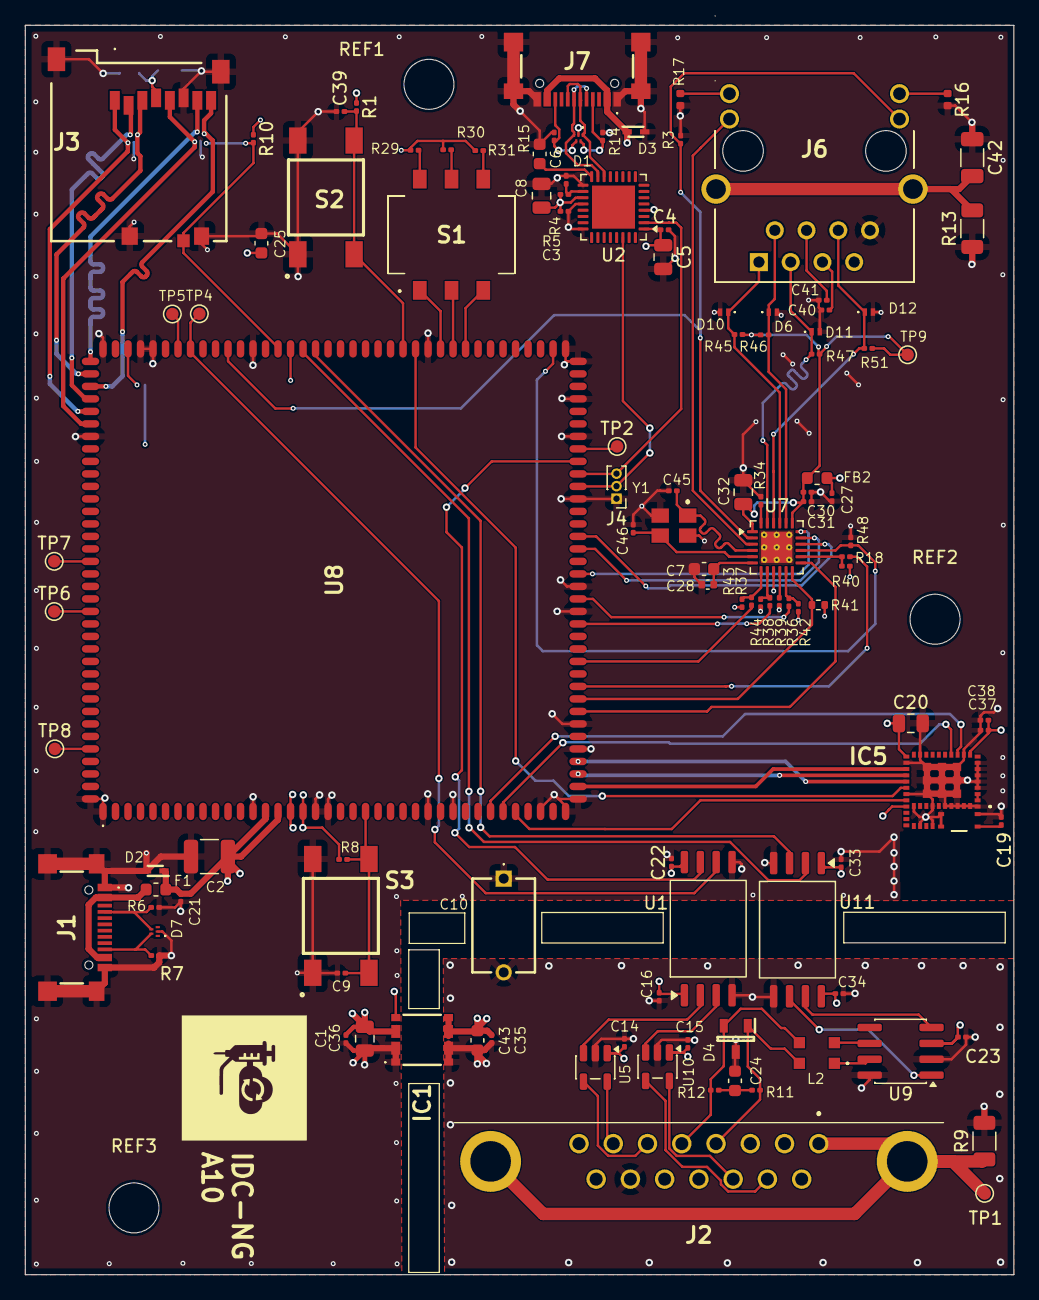
[picture p39: board idcng.kicad_pcb from above]

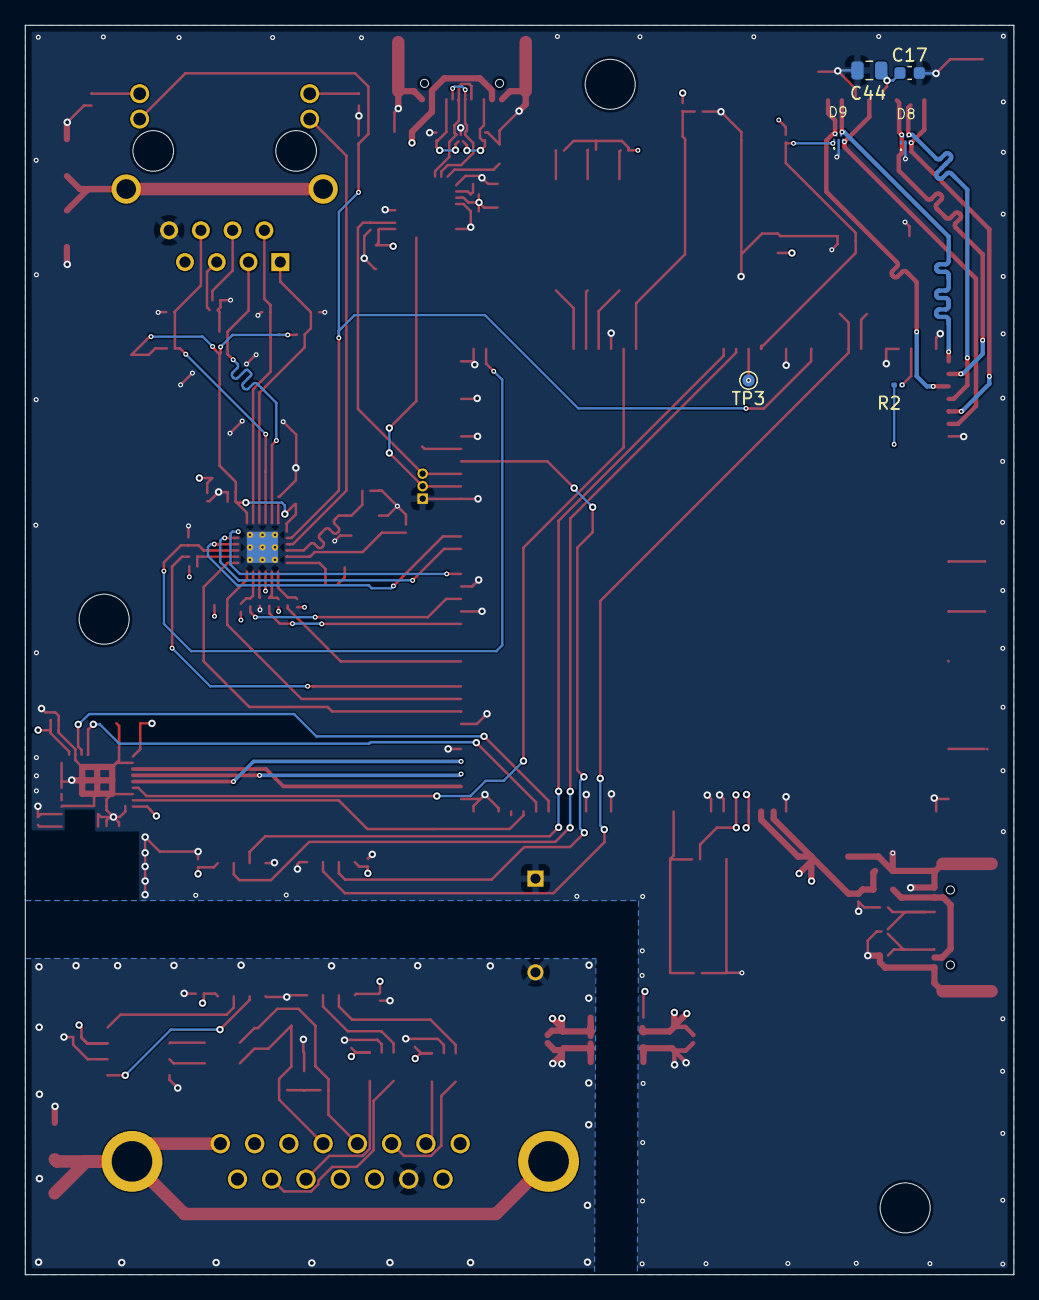
[picture p40: board idcng.kicad_pcb from below]

Board: 4 copper layers, 79.1 x 99.9 mm, 122 parts (6 on the bottom side), 97 nets.

Other parts of the board:
C25: 1u/16V; C_0603_1608Metric
R40: 10k; R_0201_0603Metric
REF1, REF2, REF3: MountingHole_4mm

Their connections:
+3V3: C25.1, R40.1; also elsewhere on the board
GND: C25.2; also elsewhere on the board
unnamed 59: R40.2; also elsewhere on the board
