InjectLink/idc_ng_hardware/(commit log)

2025-12-01 antenna review
    [idcng.kicad_pcb]
2025-12-01 ground plane on top and bottom. via stitching
    [ethernet100m.kicad_sch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]
2025-12-02 Avoid via in pads
    [idcng.kicad_pcb]
2026-01-16 fix: usb uart reverse support for usb-c
    - Fix usb-c reverse support for data link usb uart
    [idcng.kicad_pcb, usb_uart.kicad_sch]
2026-02-16 fix: ethernet clock inversion
    - Fix ethernet clock inversion and mdint for LED activity
    [ethernet100m.kicad_sch, idcng.kicad_pcb]
2026-02-16 led: remove rgb leb
    - Remove RGB LED (wt I2C controller)
    [SOM_MP135.kicad_sch, idcng.kicad_pcb]
